Johannes-Trummer/Re-EMF-Projekt/Dokumentation/Bilder PCB-Design/bestuecktePlatine.jpg

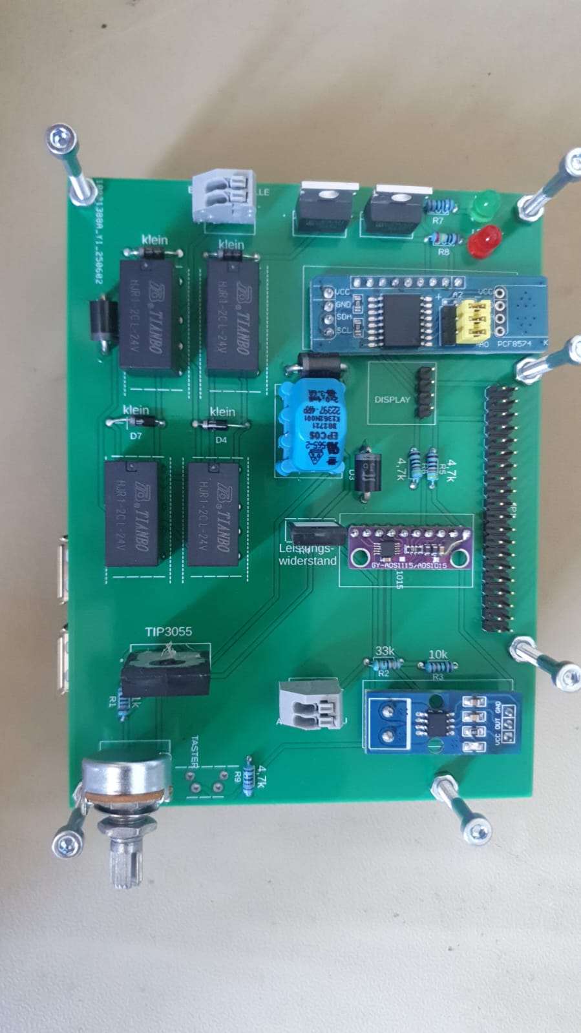
Dokumentation/Bilder PCB-Design/bestuecktePlatine.jpg
