Johannes-Trummer/Re-EMF-Projekt/Dokumentation/Dokumentation_EmbeddedSystems3.pdf

## Hochschule fur Technik, Wirtschaft und Kultur ¨

## Fakultät Ingenieurwissenschaften

# Projektarbeit

Embedded Systems 3

Thema: | Entwurf eines Re-EMF-Ladegerätes fur Bleiakkumulatoren ¨
Autor: | Leon Arnecke, Johannes Trummer MatNr. 79511, 87051
Version vom: | 29. September 2025
Prufer: ¨ | Prof. Dr.-Ing Andreas Pretschner

## Inhaltsverzeichnis

1 Einleitung | 3
2 Design des PCB | 4
2.3 Ubertragung des Schaltplans auf die Platine | ¨ | 5
2.5 Bestuckung der Platine | ¨ | 7
3 Entwurf Linux-System | 8
4 Entwurf des Programms | 12
4.1 Ziel und Modulubersicht | ¨ | 12
4.2 Einzeubersicht | ¨ | 12
5 Test und Inbetriebnahme | 15
6 Zusammenfassung und Ausblick | 19
Abbildungsverzeichnis | 20

2

## 1 Einleitung

Bleiakkumulatoren gehören trotz ihres Alters nach wie vor zu den am häufigsten eingesetzten Energiespeichern. Ihre einfache Bauweise, robuste Charakteristik und vergleichsweise niedrigen Kosten machen sie fur viele Einsatzzwecke attraktiv. Damit einher geht ¨ die Notwendigkeit einer zuverlässigen und effizienten Ladeelektronik, die sowohl die Lebensdauer der Akkumulatoren verlängert als auch eine sichere Regeneration tiefentladener Zellen ermöglicht.

Im Rahmen dieses Projekts wurde eine Re-EMF-Schaltung zur Ladung und Regeneration von Bleiakkumulatoren entwickelt. Ziel war es, den Ladevorgang durch Nutzung der Gegen-Elektromotorischen Kraft (Re-EMF) zu optimieren und ein schonendes, kontrolliertes Ladeverfahren zu realisieren. Die vollständige Schaltung wurde eigenständig entworfen und als Leiterplatte gefertigt.

Die Steuerung des Ladevorgangs ubernimmt ein STM32MP135 Mikroprozessorboard. ¨ Es läuft unter einem Linux-Betriebssystem, das mit Hilfe des Yocto-Projekts speziell
fur diesen Anwendungsfall erstellt wurde. Der zugeh ¨ | örige Ladealgorithmus wurde in der
Programmiersprache C implementiert und auf die zugrunde liegende Hardware abgestimmt.

Diese Arbeit dokumentiert die Entwicklung des Gesamtsystems – von der Konzeption der Ladeelektronik uber die Realisierung der Steuerung bis hin zur Softwareumsetzung. ¨ Dabei liegt der Fokus auf dem Zusammenspiel zwischen Hardwaredesign und softwarebasierter Steuerung zur sicheren und effektiven Ladung von Bleiakkumulatoren.

3

## 2 Design des PCB

### 2.1 Designprozess

Die vorliegende Leiterplatte wurde mit der Software Fusion 360 im integrierten Modul PCB Design entworfen. Fur die Umsetzung kam eine kostenlose Studentenlizenz zum ¨ Einsatz, die den vollen Funktionsumfang der Software fur nicht-kommerzielle Bildungs- ¨ zwecke bereitstellt. Die Nutzung dieser Lizenz ermöglichte eine professionelle Umsetzung des Designs unter Berucksichtigung aktueller Industriestandards. ¨

### 2.2 Entwurf des Schaltplans

Der Schaltplan wurde im Fusion 360 PCB Design-Modul erstellt und bildet die Grund-
lage fur das gesamte Platinenlayout. Da viele der ben ¨ | ötigten Bauteile nicht in den Stan-
dardbibliotheken enthalten waren, mussten sowohl die Schaltsymbole als auch die zugehörigen Footprints manuell erstellt werden. Die dafur erforderlichen Informationen ¨ wurden sorgfältig den jeweiligen Datenblättern der Hersteller entnommen. Diese Vorgehensweise stellte sicher, dass alle Bauteilabmessungen, Pinbelegungen und elektrischen Eigenschaften korrekt umgesetzt wurden. Trotz des erhöhten Aufwands bot Fusion 360
durch die enge Verknupfung von Schaltplan und Layout eine effiziente Umgebung f ¨ | ur ¨
die Entwicklung eines konsistenten und funktionsfähigen Designs.
In Abbildung 1 ist ein Ausschnitt des Schaltplans zu sehen, wie er in Fusion 360 PCB erstellt wurde. Die Symbole sind hauptsächlich eigens erstellt.

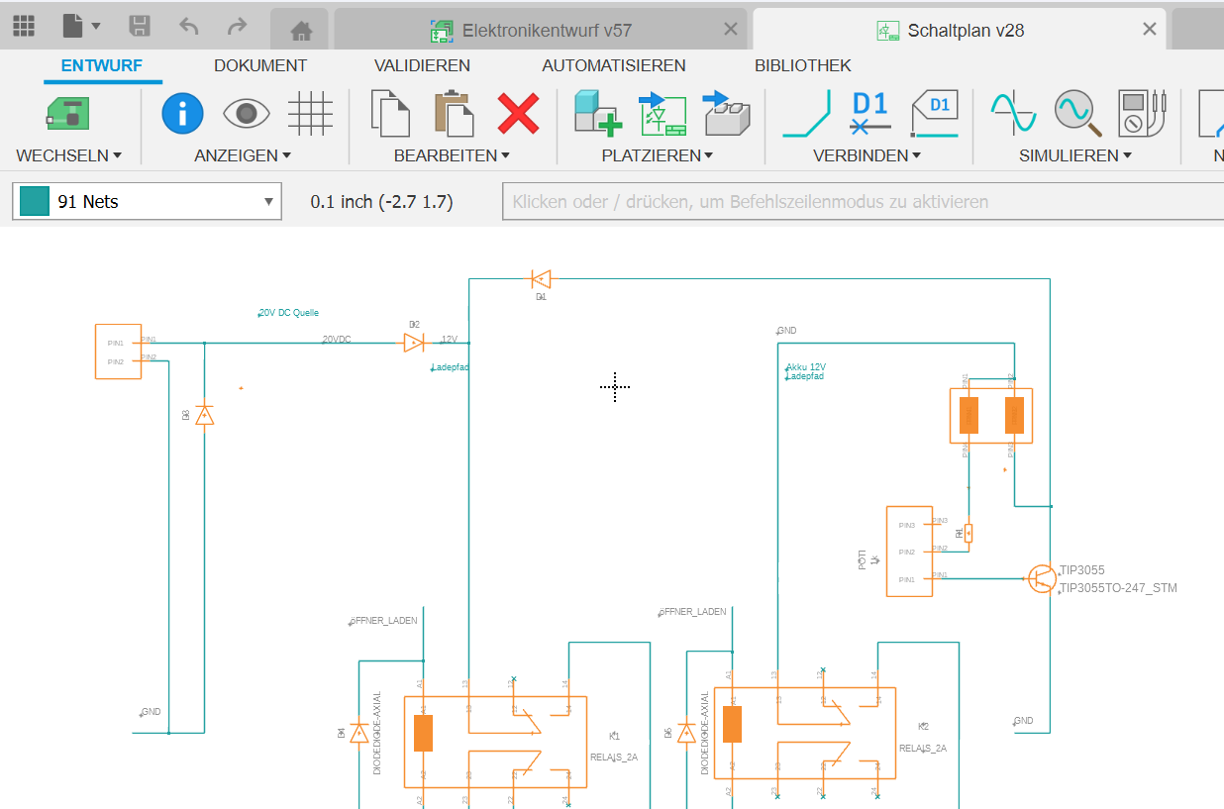
[picture p4: figure]

Abbildung 1: Ausschnitt des erstellten Schaltplans in Fusion 360 PCB Design

4

### 2.3 Ubertragung des Schaltplans auf die Platine ¨

Nach Fertigstellung des Schaltplans erfolgte die Ubertragung in das Leiterplatten-Layoutmodul ¨ von Fusion 360. Dabei wurde die im Schaltplan definierte Netzliste, die alle elektrischen Verbindungen zwischen den Bauteilen beschreibt, automatisch in das PCB-Design
ubernommen. Diese Netze dienten im Layoutprozess als Grundlage f ¨ | ur die sp ¨ | ätere Lei-
tungsfuhrung (Routing). ¨

Zunächst wurde die Grundfläche der Platine definiert, basierend auf den Platzanforderungen der Komponenten sowie den angestrebten mechanischen Abmessungen. Fur den ¨ Entwurf wurde von einer industriellen Fertigung ausgegangen, weshalb eine zweilagige Platine (2-Layer PCB) angenommen wurde – ein gängiger Standard fur viele elektroni- ¨ sche Anwendungen.

Die Platzierung der Komponenten auf der Platine erfolgte unter Berucksichtigung sinn- ¨
voller Signalflusse, minimaler Leitungsl ¨ | ängen sowie thermischer und mechanischer Aspek-
te. Dabei wurde insbesondere auf eine ubersichtliche und funktionsorientierte Anordnung ¨ geachtet, um spätere Tests, Fehlersuche und gegebenenfalls eine Bestuckung per Hand ¨ zu erleichtern.

Die zuvor im Schaltplan definierten Netzverbindungen wurden im Layout als Luftlinien dargestellt, die als visuelle Hilfe fur das Routing dienten. Diese Verbindungen ¨ wurden anschließend manuell auf den beiden verfugbaren Kupferlagen geroutet, wobei ¨ möglichst wenige Vias (Durchkontaktierungen) eingesetzt wurden, um Produktionskosten und mögliche Fehlerquellen zu minimieren.

Abbildung 2 zeigt die fertig erstellte Platine im PCB-Designer in Fusion 360 PCB. Die Löcher zum Befestigen am STM32MP135F-DK wurden aus den, von STM bereitgestellten, Unterlagen bezogen und auf der Platine platziert. Außerdem die Platine zum Schluss mit einem GND-Polygon versehen, um Störungen zu minimieren.

5

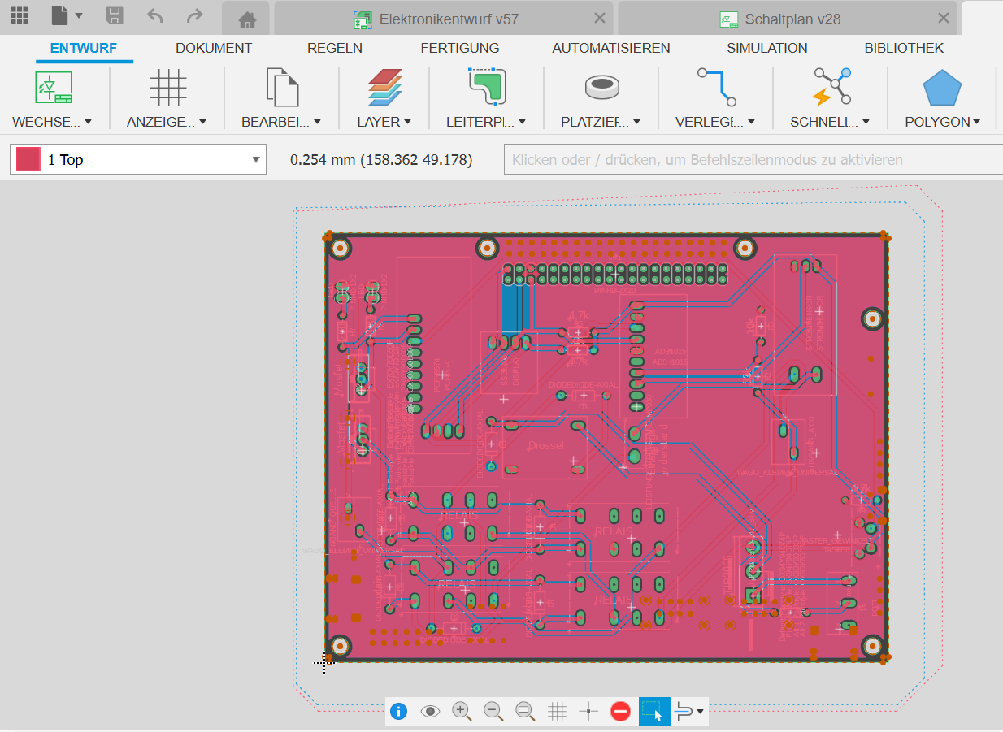
[picture p5: figure]

Abbildung 2: Fertig erstellte Platine mit Umrissen des Polygons

### 2.4 Bestellung der Platine und der Elektronikteile

Fur die Fertigung der entworfenen Leiterplatte wurde der chinesische Hersteller JLCP- ¨
CB gewählt. Dieser Anbieter bietet eine kostengunstige und zuverl ¨ | ässige Möglichkeit,
Prototypen sowie Kleinserien professionell herstellen zu lassen. Die Ubermittlung der ¨ Fertigungsdaten erfolgte in Form von standardisierten Gerber-Dateien, die direkt aus Fusion 360 exportiert wurden.
Die zur Bestuckung ben ¨ | ötigten elektronischen Bauteile wurden bei den bekannten Elek-
tronikhändlern Conrad Elektronik und Reichelt Elektronik bestellt. Diese Anbieter boten eine breite Auswahl und eine schnelle Lieferung der benötigten Komponenten, wodurch
eine zugige Inbetriebnahme der Platine erm ¨ | öglicht wurde.

6

### 2.5 Bestuckung der Platine ¨

Nach Lieferung der Leiterplatte und der elektronischen Bauteile erfolgte die manuelle
Bestuckung. Dabei wurden die zuvor bestellten Komponenten gem ¨ | äß dem Schaltplan
und dem Platinenlayout in die dafur vorgesehenen Positionen eingesetzt. Anschließend ¨ wurden alle Kontakte sorgfältig per Hand verlötet, um eine zuverlässige elektrische Verbindung herzustellen.

Die meisten Bauteile passten exakt in die vorgesehenen Bohrungen. Lediglich bei einigen wenigen Komponenten traten kleinere Probleme mit dem Lochdurchmesser auf – in diesen Fällen mussten die Anschlussdrähte leicht nachbearbeitet oder vorsichtig angepasst werden. Abgesehen davon verlief die Bestuckung weitgehend problemlos, und es konnte ¨ zugig mit der Inbetriebnahme der Schaltung fortgefahren werden. ¨

7

## 3 Entwurf Linux-System

Fur das STM32MP135F-DK wird ein Linux-Image mit Yocto gebaut, das eigene C- ¨ Programme bereits mitkompiliert im Root-Filesystem enthält. Die Builds laufen in einem Docker-Container unter Windows, um eine reproduzierbare und isolierte Umgebung zu erhalten.

### 3.1 Voraussetzungen

- Windows 10/11 mit Docker Desktop.
- Projektordner mit Dateien: Dockerfile, hello.c, aus.c, laden.c, entladen.c, analogwerte.c und zustandsautomat.c.
- Internetzugang (Yocto-Layer werden via repo synchronisiert).

### 3.2 Docker-Container bauen und starten

Bevor die eigentliche Konfiguration des Builds gestartet werden kann, muss die Buildumgebung aufgebaut und gestartet werden. Dafur wurden diese Befehle genutzt: ¨

# Windows P owe rS hell

cd C: \ U se r s \Leon\Documents\ Yo c to P roj e c t

docke r b uil d −t yocto−stm32mp1 −f D o c k e rf i l e .

docke r run −i t −−name yocto−dev −v
// c / U se r s /Leon/Documents/ Yo c to P roj e c t : / work yocto−stm32mp1

Im Container sind die Projektdateien unter /work sichtbar.

### 3.3 Yocto-Quellen und Pakete holen

# Con ta iner−S h e l l

mkdir −p ˜/stm32mp1−yoc to

cd ˜/stm32mp1−yoc to

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

repo sync −j ”$ ( nproc ) ”

8

Beim ersten envsetup.sh pruft ST Pflichtpakete. Fehlende werden nachinstalliert. ¨ sudo apt−g e t update

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

### 3.4 Build-Environment setzen

cd ˜/stm32mp1−yoc to

source l a y e r s /meta−s t / s c r i p t s / env se tup . sh

Damit wird der Build-Ordner /stm32mp1-yocto/build-openstlinuxweston-stm32mp13-disco angelegt.

### 3.5 Eigenen Layer und Sammel-Rezept erstellen

Wir bundeln alle C-Programme in einem Paket ¨ | battery-tools, das die sechs Binaries
nach /usr/bin installiert.

bi tba ke−l a y e r s c r ea t e −l a y e r . . / meta−myapp

bi tba ke−l a y e r s add−l a y e r . . / meta−myapp

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

9

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

Inhalt (Kurzfassung):

- LICENSE = MIT" mit aktuellem LIC FILES CHKSUM.
- SRC URI listet alle sechs .c-Dateien.
- do compile: sechs Binaries bauen.
- do install: nach ${bindir} installieren.

### 3.6 Paket ins Image ziehen und bauen

echo ’IMAGE INSTALL: append =
” ba t t e r y−t o o l s ” ’ >> co nf / l o c a l . co nf

echo ’ACCEPT EULA stm32mp13−di s c o = ”1” ’ >> co nf / l o c a l . co nf

bi t ba k e ba t t e r y−t o o l s

### 3.7 Image bauen (Weston-Variante)

bi t ba k e s t−image−weston

### 3.8 SD-Karten-Image erzeugen

Nach abgeschlossenem Build liegen die Artefakte in:
cd tmp−g l i b c / deploy / images /stm32mp13−di s c o

Das SD-Image wird mit dem ST-Skript aus einer TSV erstellt. Fehlende Tools wie sgdisk nachinstallieren:

10 sudo apt−g e t i n s t a l l −y g di s k

cd s c r i p t s

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

Ergebnis: FlashLayout sdcard stm32mp135f-dk-extensible.raw im Deploy-Ordner.

# P owe rS hell ( Host )

docke r cp yocto−dev : / home/ yoc to /
stm32mp1−yoc to / b uil d−o p e n s tli n u xw e s to n−stm32mp13−di s c o / tmp−g l i b c / deploy / images /stm32mp13−di s c o /
FlashLayou t sdca rd s tm32mp135f−dk−e x t e n s i b l e . raw
C: \ U se r s \Leon\Documents\ Yo c to P roj e c t \

Abschließend kann die Datei mit Hilfe von BalenaEtcher unter Windows oder mit geeigneten Werkzeugen (z. B. dd oder spezialisierte GUI-Programme) unter Linux auf eine SD-Karte geschrieben werden.

11

## 4 Entwurf des Programms

### 4.1 Ziel und Modulubersicht ¨

Das System umfasst mehrere eigenständige Testprogramme sowie ein Hauptprogramm mit Zustandsautomat. Die Module sind:

- hello – Konsolentest ("Hallo vom STM32MP13!").
- aus, laden, entladen – Einzeltests fur den I/O-Expander PCF8574. Sie initiali- ¨ sieren den Expander, setzen gezielt Pins und lesen einen Eingang.
- analogwerte – Einzeltest fur den ADC ADS1015: liest AIN0 und AIN1 zyklisch ¨ und rechnet auf Volt bzw. mA um.
- zustandsautomat – Hauptprogramm: steuert Laden/Entladen uber den PCF8574, ¨ misst Spannung/Strom via ADS1015, akkumuliert eine Ladungsgröße und verwaltet den Ablauf uber eine explizite Zustandsmaschine. ¨

### 4.2 Einzeubersicht ¨

hello. Minimaler Konsolotest zum Funktionscheck der Toolchain/RootFS.

aus / laden / entladen. Diese drei Programme initialisieren den PCF8574, konfigu-
rieren gewunschte Pins als Output oder Input und lesen zus ¨ | ätzlich Pin 2 als Eingang
(Taster). Beispielhafter Ablauf:

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

Die konkrete Belegung: Pin 0 = Laden, Pin 1 = Entladen, Pin 2 = Starttaster.

analogwerte. analogwerte misst in einer Endlosschleife nacheinander Kanal 0 und
Kanal 1 und gibt die Werte aus. Die Skalierung fur AIN0 ist aktuell ¨ | U = 4,35 ·UADC, die
Stromberechnung basiert auf I [mA] = 1000 · (9,88 · UADC − 25,27). Die Skallierung des Spannungskanals ist nötig, da die zu messende Spannung uber einen Spannungsteiler am ¨ ADC hängt. Die Parameter der Stromkurve wurden aus zwei Messpunkten berechnet.

12

### 4.3 Hauptprogramm: Zustandsmaschine

Das Hauptprogramm zustandsautomat kapselt die Steuerlogik in klar benannten Zuständen:

Z START, Z SPANNUNG MESSEN 1, Z LADEN AN, Z LADEN AUS, Z ZAEHLER ERHOEHEN,
Z ENTLADEN AN, Z ENTLADEN AUS, Z SPANNUNG MESSEN 2, Z STROM MESSEN, Z AUFSUMMIEREN,
Z ENDE
Zustandslogik (verkurzt). ¨ | Die zyklische Hauptschleife ruft ausgangslogik(zustand)
und berechnet anschließend den Folgezustand mit zustandsuebergang(zustand):

do {
a u s g a n g sl o gi k ( zu s tand ) ;
zu s tand = zu s tand suebe rgang ( zu s tand ) ;
} w hil e ( ! f e r t i g ) ;

In ausgangslogik( ) werden je nach Zustand Ausgänge gesetzt und Messungen durchgefuhrt, z.B.: ¨

- Z START:bei aktivem Taster Wechsel nach Z SPANNUNG MESSEN 1.
- Z SPANNUNG MESSEN 1 / 2: Einzelmessung ADS1015, Messung und Anzeige der Zellspannung.
- Z LADEN AN: Schalten des Lade-Relais; danach sleep(60) (Ladezeit).
- Z ENTLADEN AN: Schalten des Entlade-Relais.
- Z STROM MESSEN: ADS1015 messen, Strom ausrechnen.
- Z AUFSUMMIEREN: Ladungsgröße fortschreiben, 1 s abwarten
- Z ZAEHLER ERHOEHEN: Wiederholungszähler erhöhen
- Z ENTLADEN AUS: Entladen abschalten, Zeit-/Akkumulatoren zurucksetzen und Zwi- ¨ schenergebnis ablegen.
- Z ENDE: Messwertspeicher ausgeben, Ende.

13

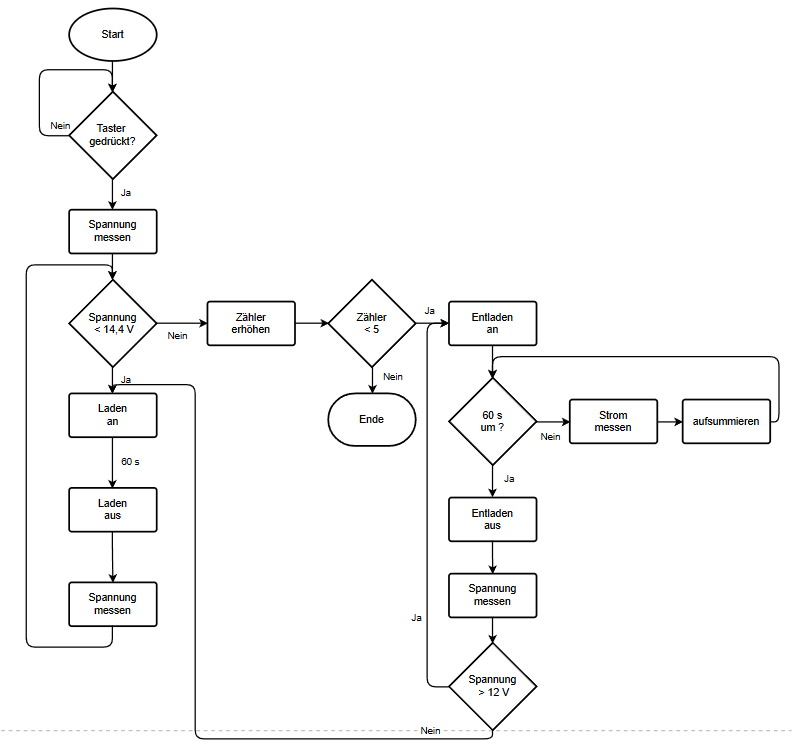
[picture p6: figure]

Abbildung 3: Ablaufdiagram

### 4.4 Zusammenfassung

Die Aufteilung in gezielte Einzeltests (PCF8574, ADS1115) erleichtert Verifikation und Fehlersuche; der Zustandsautomat orchestriert die Betriebsphasen (Laden/Entladen/-Messen) deterministisch. Das Open-Drain-Verhalten des PCF8574 (LOW = aktiv) ist da-
bei zentral fur die Relais-/Laststeuerung, w ¨ | ährend der ADS1115 im Single-Shot-Betrieb
reproduzierbare Messwerte liefert.

14

## 5 Test und Inbetriebnahme

### 5.1 Inbetriebnahme

Nachdem die Bestuckung der Platine abgeschlossen war, konnte diese f ¨ | ur die erste Inbe- ¨
triebnahme vorbereitet werden. Hierzu wurde die Baugruppe mittels eines 20×2-poligen Flachbandkabels mit dem STM32-Controller verbunden. Uber diese Verbindung werden ¨ sämtliche Steuersignale zwischen der Platine und dem Mikrocontroller ubertragen. ¨
Im Rahmen der initialen Inbetriebnahme liegt der Schwerpunkt zunächst darauf, die Baugruppe und den Controller ohne die Aktivierung spezifischer Funktionen in einen stabilen Betriebszustand zu versetzen. Auf diese Weise soll sichergestellt werden, dass die Schaltungsarchitektur sowie die Verdrahtung grundsätzlich fehlerfrei ausgefuhrt wur- ¨ den und keine unvorhergesehenen Betriebszustände auftreten.
Nachdem die Baugruppe uber einen Zeitraum von mehreren Minuten fehlerfrei betrieben ¨ wurde und weder Rauchentwicklung noch auffällige Geruchsbildung festgestellt werden konnten, kann im nächsten Schritt mit der schrittweisen Uberpr ¨ ufung der vorgesehenen ¨ Funktionen begonnen werden. Ziel ist es, die einzelnen Komponenten systematisch zu testen und die einwandfreie Funktionalität der gesamten Schaltung zu verifizieren.

15

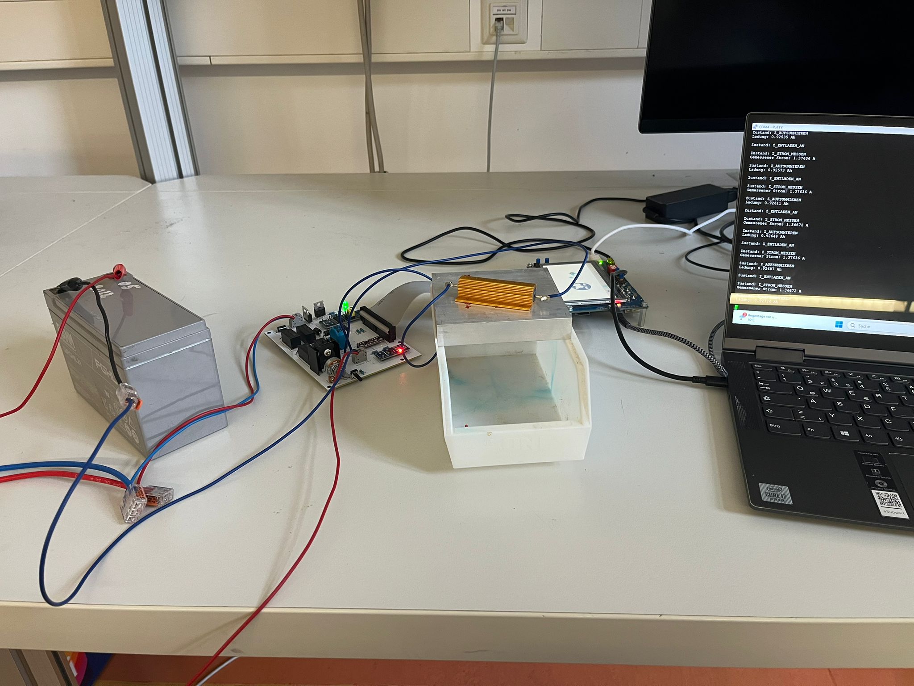
[picture p7: figure]

Abbildung 4: Platine und STM32-Controller während des ersten Akku-Zyklus

### 5.2 Test der Funktionen

Um eine ordnungsgemäße Funktion der Applikation sicherzustellen, mussen s ¨ ämtliche Funktionen systematisch und präzise getestet werden. Dabei ist es erforderlich, sowohl die zentralen Hauptfunktionen – wie den Lade- und Entladevorgang sowie den automatischen Betriebsablauf – zu uberpr ¨ ufen, als auch kleinere, jedoch nicht weniger wichtige ¨ Teilfunktionen zu validieren. Hierzu zählen beispielsweise die Kapazitätsmessung sowie die korrekte Ansteuerung der Status-LEDs.

Ein weiterer wesentlicher Aspekt betrifft die Ausgangsspannung der Schaltung. Da der primäre Zweck dieser Schaltung in der Regeneration von Bleigel-Akkus mittels gepulster Spannung liegt, ist es notwendig, die erzeugte Ausgangsspannung mithilfe eines Oszilloskops zu uberwachen und aufzuzeichnen. Auf diese Weise kann sichergestellt werden, ¨ dass die Pulsparameter den spezifizierten Anforderungen entsprechen und die Schaltung den Akku schonend und effektiv regeneriert.

### Laden

Um die Funktion des Ladens zu uberpr ¨ ufen, wird ein 12V-Blei-Gel-Akku an die Schal- ¨ tung angeschlossen. Dazu wird ein Oszilloskop parallel zum Akku angeschlossen, um

16 die Ausgangsspannung der Ladeschaltung aufzuzeichnen. Gleichzeitig muss der Ablauf des Steuerungsprogramms den richtigen Ausgang setzen, sodass der Ladepfad geschaltet wird.

### Entladen

Um den Akku zu entladen, muss der Programmablauf ebenfalls wieder den richtigen Pfad schalten, sodass der Strom aus dem Akku herausfließen und sich dieser damit entladen kann. Nun fließt der Strom aus dem Akku uber den Entladewiderstand und ¨ die Strommessung. Die Steuerung sollte nun zyklisch einen Strom messen und diesen so aufsummieren, dass die Kapazität des Akkus berechnet werden kann.

### Ausgangsspannung aufzeichnen

Die Ausgangsspannung der Ladeschaltung ist ein wichtiger Aspekt. Durch die gepulste Spannung soll im Bleiakku die Sulfatschicht um die Elektroden abgebaut werden, wodurch sich die Kapazität des Akkus in der Theorie wiederherstellen lässt. Somit ist das Pulsen der Spannung äußerst wichtig und muss mit Hilfe eines Oszilloskops aufgenommen werden, um die korrekte Funktion sicherzustellen.

### Ladungsmessung prufen ¨

Die Kapazitätsmessung an sich kann schwierig gepruft werden, da man daf ¨ | ur ein Mess- ¨
gerät bräuchte, welches die Kapazität eines Akkus misst. Die beiden Werte mussten ¨ dann verglichen werden. Da ein solches Messgerät nicht vorhanden ist, wurde die Kapa-
zitätsmessung in zwei Teilschritten uberpr ¨ | uft: erst die ¨ | Uberpr ¨ | ufung der Strommessung, ¨
dann die des zeitlichen Intervalls der Abtastung.
Die Strommessung konnte relativ einfach uberpr ¨ uft werden, indem das Entladen durch ¨ eine Spannungsquelle als Akku simuliert wurde und ein geeichtes Multimeter zur Strommessung in Reihe geschalten wurde. Uber den Entladewiderstand auf der Platine wurde ¨ dann ëntladen”. Der gemesssene Strom wurde nun an zwei Punkten mit dem gemessenen Strom des Multimeters verglichen, sodass die Kennlinie uberpr ¨ uft werden konnte. ¨
Das Testen des zeitlichen Intervalls stellte sich anfangs als nicht so einfach dar. Eine gute Möglichkeit wurde allerdings gefunden, indem die Anzahl der Abtastungen uber ¨ einen großen Zeitraum gezählt wurde. So sollte die Anzahl der Abtastungen bei einer Stunde Laufzeit beispielsweise 3600 betragen, da 3600 Sekunden. Dies war eine gute Möglichkeit, das zeitliche Intervall sehr genau einzustellen.

### Simulation des gesamten Ablaufs

Um den gesamten Programmablauf zu testen, muss sich die Spannung des Akkus entsprechend dem Lade- und Entladevorgang verändern. Da das Laden und Entladen eines

17

Akkus einige Zeit in Anspruch nimmt, wurde an dieser Stelle wieder eine Spannungsquelle als Simulation des Akkus eingesetzt. Die Startspannung liegt bei 12,5V.
Der Ladevorgang wurde nun gestartet. Die Lade-Eingangsspannung wurde nicht angelegt, da die erwähnte Spannungsquelle sonst die Ladespannung abbekommen wurde. ¨ Dadurch werden im trockenen Zustand einfach die Relais geschaltet und der Programmablauf kann getestet werden.
Die Spannung der Spannungsquelle wird nun auf 14,5V erhöht, wodurch die Steuerung im nächsten Messschritt (alle 60 Sekunden) einen fertig geladenen Akku feststellt, das Laden beendet und das Entladen startet. Auch im Zustand des Entladen wird die Spannung des Akkus alle 60 Sekunden gemessen. Dazwischen wird der Strom jede Sekunde gemessen.
Die Spannungsquelle wurde nun auf 11,8V gestellt. Jetzt wurde im nächsten Messschritt der entladene Akku festgestellt und wieder das Laden gestartet. Aktuell sind im Pro-
gramm funf Zyklen eingestellt. Der beschriebene Ablauf wurde also insgesamt f ¨ | unfmal ¨
durchlaufen, bevor das Programm sich selbst beendet. Der Programmablauf wurde damit korrekt getestet.

### Test des Zyklus mit Akku

Zu guter Letzt werden die Schaltung und der Ablauf mit einem 12V Bleiakku betrieben.
Die Voraussetzung dafur war, dass alle vorherigen Tests erfolgreich durchgef ¨ | uhrt werden ¨
konnten, was der Fall war. Nun wurde also am Akku-Port der 12V Akku angeschlossen und eine 20V DC-Quelle am Port fur die Eingangsspannung. ¨
Nach dem Start des Zyklus wird als Erstes entladen. Dabei wird auf dem Serial Output bei jeder Messung der Strom sowie die kumulierte Ladung angezeigt. Erreicht der Akku im Leerlauf eine Spannung von unter 12V, so schaltet die Steuerung nun in den Modus laden um. Nun wird der Akku geladen, bis er im Leerlauf eine Spannung von uber 14,4V ¨ erreicht.
Abschließend konnte durch diesen Test die Funktion sowohl der Schaltung als auch der Steuerung validiert werden. Es war in beiden Modi Laden und Entladen ersichtlich, dass die erwarteten Ergebnisse eingetreten sind und der Akku sich jeweils wie erwartet verhielt.

18

## 6 Zusammenfassung und Ausblick

Zusammenfassend wurde während des Projekts eine Applikation entwickelt, mit der ein 12V Akkumulator in einem vollautomatischen Zyklus geladen und anschließend wieder entladen werden kann. Dabei wird die Leerlaufspannung des Akkus konstant uberwacht ¨ und mittels Strommessung die Kapazität/ Elektrische Ladung des Akkus gemessen. Anhand der Messung und der zyklischen Wiederholung kann am Ende mehrerer Zyklen verglichen werden, wie sich die elektrische Ladung nach dem Laden des Akkus mit der Regenerationsschaltung entwickelt hat.
Die gepulste Spannung, die fur die Desulfatierung der Elektroden dienen sollte, konnte ¨ während der Messungen nicht aufgezeichnet werden. Allerdings könnte dies daran liegen, dass der Widerstand des Akkus so gering ist, dass der Akku die Spannungsspitzen sofort wegzieht und das Oszilloskop zu träge ist, um die Spitzen zu messen.
Auch ohne Pulse kann festgehalten werden, dass der Akku zuverlässig geladen werden konnte. Eine genaue Aussage, ob die Akkus regeneriert werden, ist zum aktuellen Zeitpunkt noch nicht möglich. Während des Projekts wurden Akkus mit ursprunglich 7,2 ¨ Ah verwendet. Bei realistisch noch möglichen 4-5 Ah und einem Entladestrom von 1,4 A dauert ein einziger Entladevorgang fast drei Stunden. Um eine ordentliche Aussage tref-
fen zu können, sollten mindestens funf Zyklen durchlaufen werden. Die n ¨ | ötige Zeit zum
funfmaligen Laden und Entladen konnte w ¨ | ährend des Projekts nicht zusammenhängend
aufgebracht werden.
Aus diesem Grund soll in Zukunft zunächst ein kleinerer Akku verwendet werden, da
die Zeiten dadurch deutlich verkurzt werden k ¨ | önnen. Dies gilt als wesentlicher Verbes-
serungsvorschlag.
Weitere Verbesserungsmöglichkeiten sind:
- genauere Strommessung - die Genauigkeit der Strommessung kann verbessert werden, da der aktuelle Messbereichsendwert 5 A beträgt
- graphische Darstellung des Verlaufs der elektrischen Ladung - eine graphische Darstellung der elektrischen Ladung wurde die Ergebnisse anschaulicher ¨ machen
- Usability - die Usability könnte beispielsweise durch Nutzung des Displays des STM-Controllers verbessert werden
- Verwendung anderer Drossel - durch die Verwendung einer anderen Drossel könnte das Pulsen der Spannung eventuell verstärkt werden, sodass es auf dem Oszilloskop sichtbar wird

Es wäre denkbar, diese Verbesserungen in Zukunft umzusetzen, um eine finale Aussage treffen zu können, ob die Re-EMF-Schaltung die elektrische Ladung von Bleiakkumulatoren effektiv regenerieren kann.

19

## Abbildungsverzeichnis

1 | Ausschnitt des erstellten Schaltplans in Fusion 360 PCB Design | | 4
2 | Fertig erstellte Platine mit Umrissen des Polygons | | 6
3 | Ablaufdiagram | | 14
4 | Platine und STM32-Controller während des ersten Akku-Zyklus | | 16

20
