Johannes-Trummer/Re-EMF-Projekt/SystemsEngBeleg/Dokumentation_Systemsengineering.pdf

## Hochschule fur Technik, Wirtschaft und Kultur ¨

## Fakultät Ingenieurwissenschaften

# Abschlussarbeit

Systemsengineering

Thema: | Entwurf eines Re-EMF-Ladegerätes fur Bleiakkumulatoren ¨
Autor: | Leon Arnecke, Johannes Trummer
| MatNr. 79511, 87051
E-Mail Leon: | leon.arnecke@stud.htwk-leipzig.de
E-Mail Johannes: | johannes.trummer@stud.htwk-leipzig.de
Version vom: | 5. Juni 2025
Prufer: ¨ | Prof. Dr.-Ing Thomas Neumuth

## Inhaltsverzeichnis

1 Einfuhrung ¨ | 3
1.2 Anwendungsubersicht und Nutzungskontext | ¨ | 3
1.4 Rahmenbedingungen fur die Systemauslegung | ¨ | 5
2 Systembeschreibung | 7
2.3 Technische und Physikalische Widerspruche | ¨ | 10
2.3.1 | Technische Widerspruche | ¨ | 10
2.3.2 | Physikalische Widerspruche | ¨ | 12
3 Systementwurf | 14
3.1 Auflösung der technischen Widerspruche | ¨ | 14
3.2 Auflösung der physikalischen Widerspruche | ¨ | 15
3.4 Uberblick Ladealgorithmus | ¨ | | 16
3.5.5 | Mechanik und Kuhlung | ¨ | 19
4 Zusammenfassung und Fazit | 21
5 Eidesstattliche Erklärung | 22
Abbildungsverzeichnis | 23
Literaturverzeichnis | 24

2

## 1 Einfuhrung ¨

### 1.1 Aufgabenstellung

Die Entwicklung effizienter Ladeverfahren fur Batterien und Akkumulatoren ist ein zen- ¨ trales Thema in der modernen Energietechnik.

In dieser Arbeit wird ein systematischer Zugang zur Thematik des Ladens von Energiespeichern verfolgt. Im ersten Schritt erfolgt eine umfassende Systemanalyse, mit der das technische und funktionale Umfeld eines Ladesystems beschrieben und eingegrenzt wird. Ziel ist es, die relevanten Komponenten, Wechselwirkungen und Rahmenbedingungen zu erfassen, die beim Laden von Akkumulatoren eine Rolle spielen.

Darauf aufbauend werden die Anforderungen an ein ideales Ladesystem formuliert. Im Abgleich mit bestehenden Systemen werden zentrale Widerspruche und techni- ¨ sche Zielkonflikte identifiziert. Diese dienen als Ausgangspunkt fur die Anwendung ¨ der TRIZ-Methode (Theorie des erfinderischen Problemlösens), mit der syste-
matisch Lösungsideen fur widerspr ¨ | uchliche Anforderungen entwickelt werden k ¨ | önnen.

Im weiteren Verlauf der Arbeit werden verschiedene technologische Konzepte zur Realisierung eines geeigneten Ladesystems gegenubergestellt und bewertet. Abschließend wird ¨ eine bevorzugte Lösungstechnologie ausgewählt und durch eine technische Implementierung detailliert beschrieben. Ziel dieser Arbeit ist es, ein strukturiertes Verständnis fur die Konstruktion innovativer Ladesysteme zu gewinnen und eine methodisch fun- ¨ dierte Lösung zu erarbeiten.

### 1.2 Anwendungsubersicht und Nutzungskontext ¨

Die folgende Abbildung veranschaulicht zentrale Nutzungsszenarien und Interaktionen verschiedener Akteure mit dem Ladesystem. Im Fokus stehen dabei der Endnutzer, das Entwicklerteam sowie ein ubergeordnetes System, das etwa in einer vernetzten Infra- ¨ struktur oder einem Energieverbund agiert.

Der Endnutzer initiiert den Prozess durch das Anschließen eines Akkus. Daraufhin kann wird ein Ladevorgang mit einer Regeneration eingeleitet. Im Anschluss steht der
geladene und regenerierte Akku wieder zur Verfugung. Zus ¨ | ätzlich werden akkuspezifi-
sche Informationen bereitgestellt.

Der Entwickler nutzt gesammelte Betriebsdaten zur gezielten Systemverbesserung. Die-
ser Ruckkopplungsprozess unterst ¨ | utzt die iterative Weiterentwicklung des Ladesystems ¨
auf Basis realer Einsatzbedingungen.

3

Das ubergeordnete System ¨ | greift sowohl auf Daten des Ladeprozesses als auch auf
Regenerationsfunktionen zu. Es kann diese Informationen fur ¨ ubergeordnete Aufgaben ¨ wie Energiemanagement oder das Recycling nicht mehr verwendbarer Akkus nutzen.

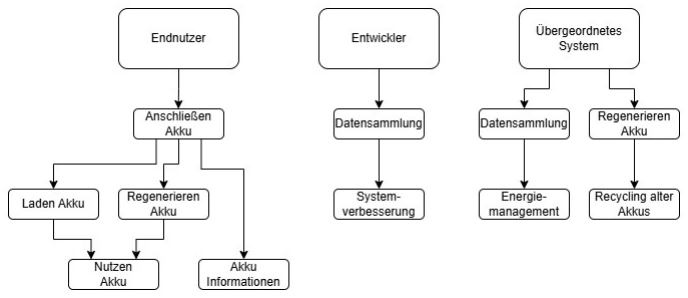
[picture p8: figure]

Abbildung 1: Use-Case-Diagramm

### 1.3 Systemumfeld

Das Systemumfeld eines Ladesystems fur Batterien und Akkumulatoren l ¨ | ässt sich in
drei wesentliche Einflussbereiche gliedern: Personengruppen, Umweltbedingungen und Fremdsysteme. Diese Kategorien stellen unterschiedliche Anforderungen an die Gestaltung, Sicherheit und Funktionsweise des Systems. Zu den mit dem System interagierenden Personengruppen zählen Endnutzerinnen und Endnutzer, Wartungspersonal, Entwicklungsund Fertigungspersonal. Das Ladesystem kann unterschiedlichen Umwelteinflussen aus- ¨ gesetzt sein, je nach Einsatzgebiet. Wesentliche Einflussfaktoren sind Temperatur, Feuchtigkeit und Staub, Mechanische Belastungen, Elektromagnetische Einflusse. Auch Fremd- ¨ systeme spielen hier eine Rolle, die Ladestation kann auf externe Energiesysteme oder Datenspeichersysteme angewiesen sein. Außerdem ist zur netzwerkbasierten Kommunikation ein entsprechendes System sinnvoll.

Die genannten Anforderungen aus dem Personen-, Umwelt- und Systemkontext bilden
die Grundlage fur die sp ¨ | ätere Systemauslegung und fließen direkt in die Bewertung
möglicher Lösungskonzepte ein.

4

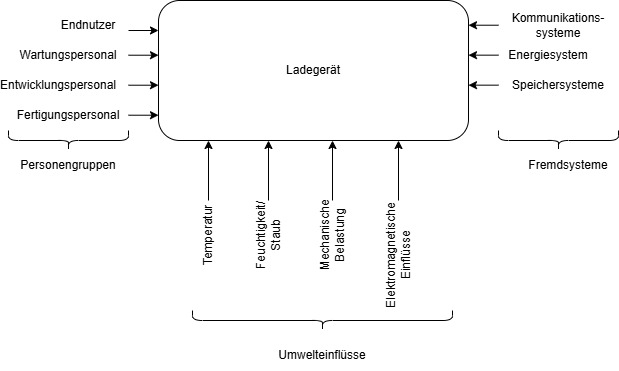
[picture p9: figure]

Abbildung 2: Systemumfeld des Ladesystems

### 1.4 Rahmenbedingungen fur die Systemauslegung ¨

Zur Festlegung der zu berucksichtigenden Rahmenbedingungen, werden oben genann- ¨
te Einflussgruppen auf deren Bedurfnisse und Anforderungen gepr ¨ | | uft. Dies dient der ¨
genaueren analyse der Systemeigenschaften.

### 1.4.1 Personen

- Endnutzerinnen und Endnutzer: Sie bedienen das Gerät im Alltag. Fur diese ¨ Zielgruppe sind insbesondere Aspekte wie einfache Handhabung, selbsterklärende
Benutzerfuhrung, visuelles Feedback ¨ | uber Ladezust ¨ | ände und ein sicherer Betrieb
von zentraler Bedeutung. Auch die potenzielle Fehlbedienung muss berucksichtigt ¨ werden.
- Wartungspersonal: Fur diese Gruppe ist ein einfacher Zugang zu technischen ¨ Komponenten essenziell, etwa zur Prufung, Kalibrierung oder zum Austausch de- ¨ fekter Bauteile. Das System sollte eine Diagnosemöglichkeit sowie dokumentierte Schnittstellen bieten.
- Entwicklungs- und Fertigungspersonal: Diese Gruppe benötigt ein modulares und nachvollziehbares Systemdesign, um Herstellung, Montage, Inbetriebnahme und Weiterentwicklung zu erleichtern.

5

### 1.4.2 Umwelt

- Temperatur: Schwankungen in der Umgebungstemperatur können sich auf die Ladeeffizienz und die Sicherheit des Systems auswirken. Es muss ein geeigneter Temperaturbereich spezifiziert und durch konstruktive Maßnahmen (z. B. Kuhlung, ¨ Schutzschaltungen) abgesichert werden.
- Feuchtigkeit und Staub: Bei Einsatz in Außenbereichen oder Werkstätten muss das Gerät gegen Feuchtigkeit und Staub geschutzt sein. Eine entsprechende IP- ¨ Schutzklasse (z. B. IP54 oder höher) ist anzustreben.
- Mechanische Belastungen: Vibrationen, Erschutterungen oder St ¨ | öße – insbe-
sondere bei mobilen oder industriellen Anwendungen – erfordern eine robuste Bauweise und die sichere Befestigung empfindlicher Komponenten.
- Elektromagnetische Einflusse: ¨ | Das Gerät muss sowohl störungsarm arbeiten
als auch unempfindlich gegenuber elektromagnetischen St ¨ | örungen sein. Entspre-
chende EMV-Richtlinien sind einzuhalten.

### 1.4.3 Fremdsysteme

- Kommunikationssysteme: Das Ladegerät muss nahtlos in bestehende Kommunikationsinfrastrukturen integriert werden können, um Statusinformationen, Diagnosedaten oder Steuerbefehle auszutauschen. Dabei sind standardisierte Schnittstellen (z. B. CAN, UART, Ethernet) und Protokolle essenziell. Kompatibilität, Datenintegrität und Echtzeitfähigkeit spielen eine zentrale Rolle.
- Energiesystem: Das Ladegerät ist Bestandteil eines ubergeordneten Energiesy- ¨ stems und muss daher mit unterschiedlichen Energiequellen (Netzspannung, Generatoren, Solaranlagen) kompatibel sein. Schutzmechanismen gegen Spannungs-
schwankungen, Ruckspeisung und Netzst ¨ | örungen sind erforderlich.
- Speichersysteme: Datenspeichersysteme ermöglichen die Erfassung, Ablage und Analyse von Betriebs- und Diagnosedaten des Ladegeräts. Eine zuverlässige Anbindung uber geeignete Schnittstellen sowie ein sicherer und strukturierter Datenzu- ¨ griff sind entscheidend. Datenschutz, Datensicherheit und langfristige Verfugbarkeit ¨
der gespeicherten Informationen mussen gew ¨ | ährleistet sein.

6

## 2 Systembeschreibung

Das Ladegerät besteht aus mehreren funktionalen Einheiten, die gemeinsam das Laden und Regenerieren von Batterien oder Akkumulatoren ermöglichen und dabei verschiedene Anforderungen erfullen. Die zentrale Komponente ist die Steuerungseinheit, welche ¨ den gesamten Ladevorgang uberwacht und regelt. Sie ist mit einem Energiemodul ver- ¨ bunden, das entweder aus einer netzgebundenen Stromversorgung oder einer autarken Quelle wie einem Solarpanel besteht.

Fur die ¨ | Uberwachung relevanter physikalischer Gr ¨ | ößen wie Strom, Spannung und Tem-
peratur ist ein Messsystem integriert. Es liefert kontinuierlich Daten an die Steuerung, um eine bedarfsgerechte Regelung des Ladeprozesses zu ermöglichen. Zusätzlich existiert eine Benutzerschnittstelle, uber die Statusinformationen abgerufen und Einstellungen ¨ vorgenommen werden können.

Ein weiteres Modul dient der externen Kommunikation, beispielsweise zur Datenubertragung ¨ an ein zentrales System oder zur Fernkonfiguration. Die einzelnen Systemteile sind so konzipiert, dass sie modular und austauschbar aufgebaut sind, was die Wartung und Weiterentwicklung erleichtert.

Die Auslegung erfolgt unter Berucksichtigung robuster Umweltbedingungen, einer ef- ¨ fizienten Energieausnutzung sowie einfacher Bedienbarkeit durch unterschiedliche Benutzergruppen.

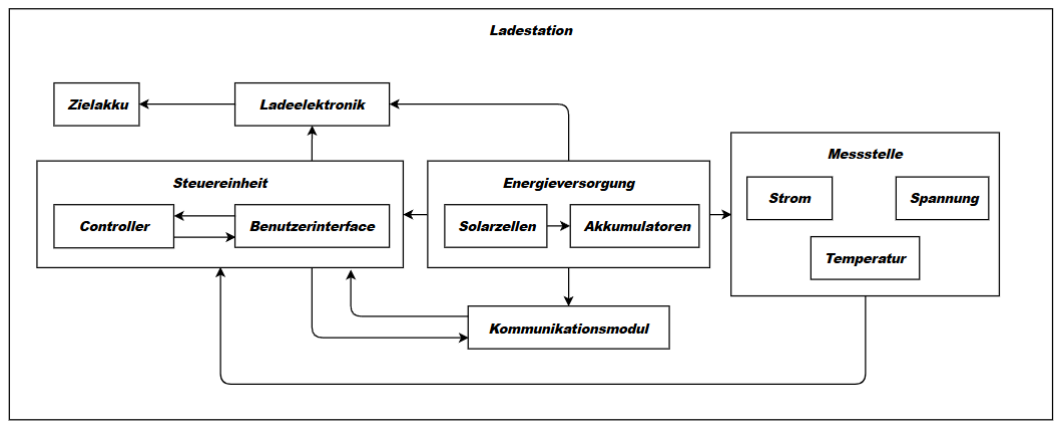
[picture p10: figure]

Abbildung 3: Block-Definition-Diagramm

7

### 2.1 Konzept des idealen Systems

Das Modell des idealen Systems beschreibt einen theoretisch optimalen Lade- und Re-
generationsprozess fur Akkumulatoren und Batterien, der sich vollst ¨ | ändig an den phy-
sikalischen, ökologischen und nutzerspezifischen Anforderungen orientiert – ohne dabei durch technische oder wirtschaftliche Einschränkungen begrenzt zu sein.

Ein ideales Ladesystem zeichnet sich durch folgende Merkmale aus:

- Automatische Anpassung: Das System erkennt automatisch den Typ, den Zustand und die Ladung der angeschlossenen Batterie und wählt den optimalen Ladealgorithmus entsprechend aus – unabhängig vom Hersteller oder der Technologie
(z. B. Li-Ion, NiMH, Blei).
- Effizienz: Der Ladevorgang erfolgt mit maximal möglichem Wirkungsgrad, d. h. es wird so wenig Energie wie möglich in Form von Wärme oder Verlustleistung verschwendet.
- Langlebigkeit: Das System verlängert durch eine schonende Ladekurve aktiv die Lebensdauer der Batterie. Uberladung, Tiefentladung oder Zellungleichgewichte ¨ werden zuverlässig vermieden.
- Regeneration: Das System ist in der Lage, bereits geschädigte oder gealterte Batterien zu analysieren und – sofern möglich – durch geeignete Ladeimpulse oder Regenerationszyklen wieder zu reaktivieren.
- Autarke Energieversorgung: Idealerweise benötigt das System keine externe Stromversorgung, sondern arbeitet vollständig energieautark (z. B. uber Solarener- ¨ gie), ohne Einbußen bei Ladeleistung oder -geschwindigkeit.
- Benutzerfreundlichkeit: Der Ladeprozess erfolgt fur die Nutzerin oder den Nut- ¨ zer vollständig automatisch. Eine Anzeige informiert uber den Ladefortschritt, oh- ¨ ne dass technisches Wissen notwendig ist.
- Nachhaltigkeit: Das System ist ressourcenschonend konstruiert, reparierbar und auf eine lange Lebensdauer ausgelegt. Es erfullt aktuelle Umweltstandards und ¨ kann sicher recycelt werden.

Dieses Idealmodell dient als Referenz zur späteren Bewertung realer Lösungsansätze. Abweichungen von diesem Modell deuten auf notwendige technische Kompromisse hin, deren Ursachen analysiert und deren Auswirkungen minimiert werden sollen.

8

### 2.2 Modellierung der Anforderungen

Das unten gezeigte Anforderungsdiagramm stellt die funktionalen und nicht-funktionalen Anforderungen an die Ladestation strukturiert dar. Die Anforderungen gliedern sich in mehrere Hauptkategorien:

- Energieversorgung: Die Ladestation soll eine autarke Energieversorgung ermöglichen, beispielsweise durch den Einsatz erneuerbarer Energien wie Photovoltaik. Zudem ist eine hohe Energieeffizienz gefordert, um den Energieverbrauch zu minimieren und einen nachhaltigen Betrieb sicherzustellen.
- Bedien- und Kommunikationsanforderungen: Diese Kategorie umfasst alle grundsätzlichen Interaktionseigenschaften der Ladestation. Dazu gehören z. B. die Fähigkeit zur Zustandsanzeige, um Nutzer uber den Ladefortschritt zu informieren, ¨ sowie die Kommunikationsfähigkeit mit externen Systemen. Zusätzlich wird gefordert, dass die Ladestation verschiedene Ladeprofile unterstutzt, um sich flexibel ¨ an unterschiedliche Anwendungsfälle und Bedienerwunsche anzupassen. ¨
- Sicherheits- und Diversitätsanforderungen: Diese Gruppe umfasst alle Anforderungen, die sich auf das sichere und anpassbare Laden unterschiedlicher Akkutypen beziehen. Die Ladestation muss verschiedene Akkutypen erkennen und
unterstutzen, indem sie Ladestr ¨ | öme und -spannungen entsprechend anpasst. Um
einen sicheren Betrieb zu gewährleisten, sind Schutzmechanismen wie Uberladeschutz ¨ und eine kontinuierliche Temperaturuberwachung zwingend erforderlich. ¨
- Betriebs- und Umgebungsanforderungen: Fur einen zuverl ¨ | ässigen und war-
tungsarmen Betrieb sind Anforderungen hinsichtlich einfacher Wartung und robuster Bauweise entscheidend. Die Ladestation muss unter verschiedenen Umwelt-
einflussen (z. B. Feuchtigkeit, Staub, Temperatur) zuverl ¨ | ässig funktionieren, was
durch eine entsprechend widerstandsfähige Konstruktion zu gewährleisten ist.

9

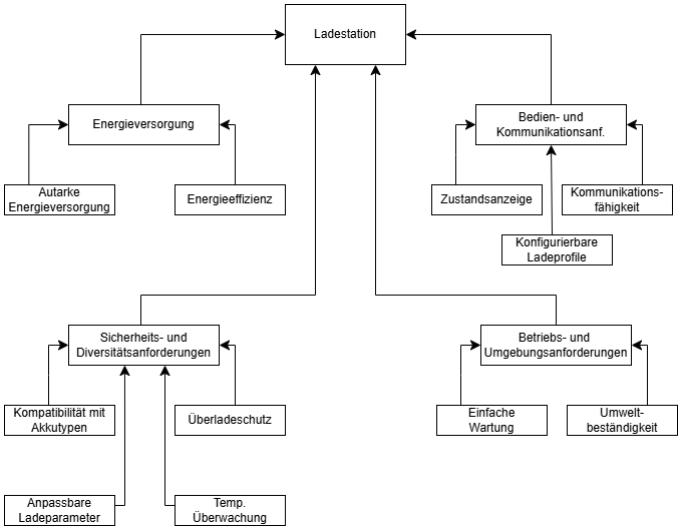
[picture p11: figure]

Abbildung 4: Requirements-Diagramm des Ladesystems

### 2.3 Technische und Physikalische Widerspruche ¨

### 2.3.1 Technische Widerspruche ¨

Technische Widerspruche treten auf, wenn durch die Verbesserung einer Eigenschaft des ¨ Systems eine andere Eigenschaft gleichzeitig verschlechtert wird.

Beispiele fur technische Widerspr ¨ | uche: ¨
- Schnellladung vs. Akkulebensdauer
Verbesserung: Die Ladezeit wird durch höheren Strom deutlich verkurzt. ¨ Verschlechterung: Die thermische und chemische Belastung verringert die Lebensdauer des Akkus.
- Hohe Effizienz vs. Baugröße der Schaltung
Verbesserung: Durch größere Kuhlk ¨ örper und leistungsfähige Bauteile wird der Wirkungsgrad verbessert.
Verschlechterung: Das System wird schwerer und weniger mobil.

10

- Energieeinsparung vs. Datenuberwachung ¨
Verbesserung: Durch Sleep-Modus wird der Stromverbrauch reduziert. Verschlechterung: Die zeitliche Auflösung der Messdaten sinkt, wichtige Informationen können verloren gehen.
- Hohe Kompatibilität vs. Komplexität der Steuerung
Verbesserung: Das Ladegerät kann verschiedene Akku-Typen verarbeiten. Verschlechterung: Die Software- und Hardwaresteuerung wird deutlich komplexer.

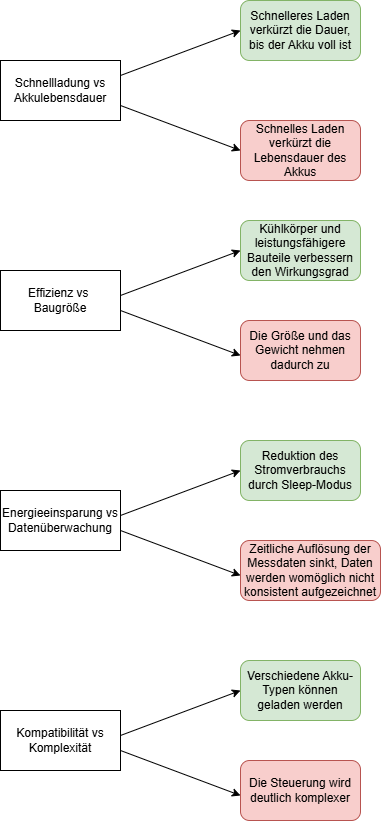
[picture p12: figure]

Abbildung 5: Technische Widerspruche ¨

11

### 2.3.2 Physikalische Widerspruche ¨

Physikalische Widerspruche liegen vor, wenn eine Eigenschaft eines Systems zwei entge- ¨ gengesetzte Anforderungen gleichzeitig erfullen soll. ¨

Beispiele fur physikalische Widerspr ¨ | uche: ¨ | [3]
- Die Temperatur der Schaltung soll niedrig und hoch sein
Begrundung: ¨ | Sie soll niedrig sein, um Bauteile zu schutzen, aber hoch genug, um ¨
die chemischen Prozesse beim Laden effizient zu gestalten.
- Die Bauform soll kompakt und gleichzeitig groß sein
Begrundung: ¨ | Kompakt fur Mobilit ¨ | ät, aber groß genug, um ausreichend Kuhlung ¨
und Bauraum fur leistungsf ¨ | ähige Komponenten zu bieten.
- Der Ladeprozess soll automatisiert und gleichzeitig individuell steuerbar sein
Begrundung: ¨ | Vollautomatisch fur einfachen Betrieb, aber auch flexibel f ¨ | ur unter- ¨
schiedliche Batterieparameter.
- Die Ladezeit soll kurz und lang sein
Begrundung: ¨ | Kurz, um Zeit zu sparen, aber lang, um den Akku besonders schonend
zu laden.

12

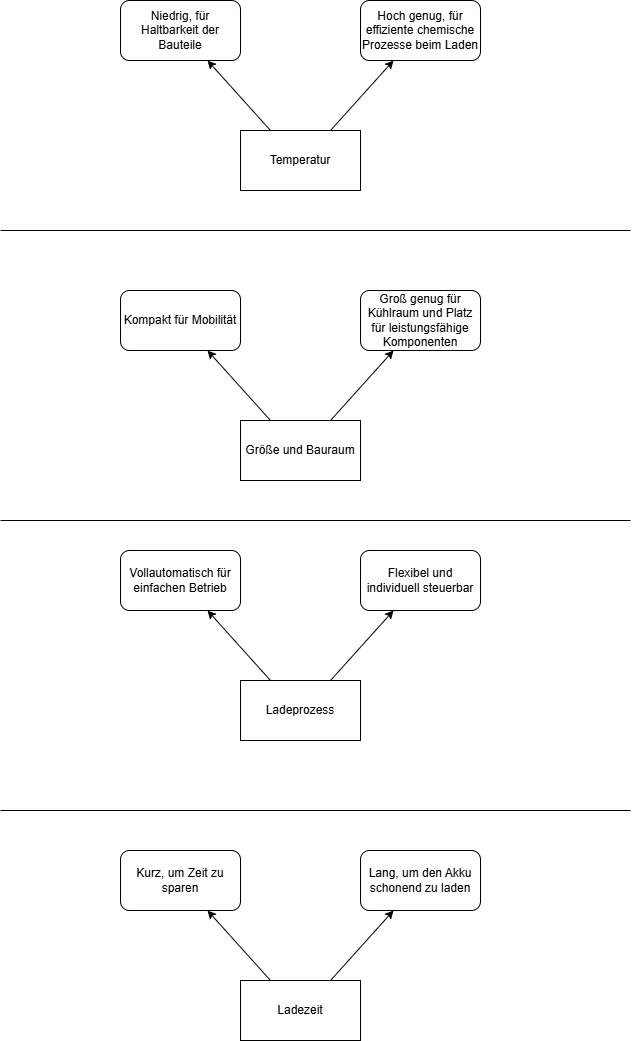
[picture p13: figure]

Abbildung 6: Physikalische Widerspruche ¨

13

## 3 Systementwurf

Im Rahmen dieser Arbeit wurden verschiedene technische und physikalische Wider-
spruche im Zusammenhang mit dem Aufbau eines Ladesystems f ¨ | ur Akkus und Bat- ¨
terien identifiziert. Zur strukturierten Lösung dieser Konflikte wird die TRIZ-Methode (Theorie des erfinderischen Problemlösens) herangezogen.

### 3.1 Auflösung der technischen Widerspruche ¨

Widerspruch 1: Eine hohe Ladespannung fuhrt zu schnellerem Laden, erh ¨ | öht aber
auch die Gefahr der Uberhitzung und Sch ¨ | ädigung der Batterie.
TRIZ-Lösung: Prinzip 19 – Periodische Wirkung: Statt konstanter hoher Spannung wird mit gepulster Spannung geladen, was die Batterie schont und gleichzeitig schnelles Laden erlaubt.[9]
Widerspruch 2: Mehr Kuhlung bedeutet besserer Wirkungsgrad, aber gr ¨ | ößere Bau-
form.
TRIZ-Lösung: Prinzip 6 – Universelle Nutzung: Das Gehäuse der Ladestation
ubernimmt zus ¨ | ätzlich die Funktion eines Kuhlk ¨ | örpers.[9]

Widerspruch 3: Ein Sleep-Modus reduziert den Energieverbrauch, verringert jedoch die zeitliche Auflösung der Datenuberwachung, wodurch wichtige Informationen verloren ¨ gehen können.
TRIZ-Lösung: Prinzip 23 – Ruckkopplung: ¨ | Das System verbleibt im Energiesparmo-
dus und wird nur bei relevanten Ereignissen durch Sensorsignale oder definierte Schwellenwerte aktiviert.[9]

Widerspruch 4: Ein Ladegerät, das viele Akku-Typen unterstutzt, bietet hohe Kom- ¨ patibilität, erfordert jedoch eine komplexe Steuerung, was Entwicklung und Wartung erschwert.
TRIZ-Lösung: Prinzip 25 – Selbstbedienung: Der angeschlossene Akku identifiziert
sich selbst uber eine digitale Schnittstelle (z. B. SMBus oder I2C) und ¨ | ubermittelt die ¨
notwendigen Ladeparameter direkt an das System.[9]

14

### 3.2 Auflösung der physikalischen Widerspruche ¨

Widerspruch 1: Die Temperatur des Akkus soll hoch sein, um chemische Prozesse zu
begunstigen, aber gleichzeitig niedrig, um Sch ¨ | | äden zu vermeiden.
TRIZ-Lösung: Trennung in der Zeit: Der Akku wird nur in kontrollierten Ladephasen leicht erwärmt, anschließend wieder gekuhlt. ¨

Widerspruch 2: Die Bauform soll gleichzeitig kompakt (platzsparend) und groß (fur ¨ Kuhlung und Bauraum) sein. ¨
TRIZ-Lösung: Trennung im Raum und Funktion: Kompakte, modulare Bauweise
mit ausgelagerten, belufteten Bereichen f ¨ | ur w ¨ | ärmeintensive Komponenten, sodass das
Hauptgerät mobil und platzsparend bleibt, während Kuhlung und Bauraum gew ¨ | ährleistet
sind.

Widerspruch 3: Der Ladeprozess soll automatisiert und gleichzeitig individuell steuerbar sein.
TRIZ-Lösung: Trennung der Bedingung: Automatischer Ladeprozess läuft unter Standardbedingungen, individuelle Steuerung wird nur bei speziellen Batterietypen oder Anforderungen aktiviert.

Widerspruch 4: Die Ladezeit soll kurz (schnellladen) und lang (vollgeladener und gut regenerierter Akku) sein.
TRIZ-Lösung: Trennung nach Zustand: Ladegeschwindigkeit wird abhängig vom Ladezustand des Akkus geregelt – zu Beginn schnell, bei hohem Ladezustand langsamer und schonender.

15

### 3.3 Interaktion zwischen Systemkomponenten

Das folgende Sequenzdiagramm stellt den allgemeinsten Ablauf eines Ladevorgangs aus Sicht der beteiligten Systemkomponenten dar. Die Interaktion beginnt mit dem Anschließen eines Akkus durch den Endnutzer. Uber das Benutzerinterface wird die Steuerungs- ¨ einheit aktiviert, welche die Sensorik abfragt und auf Basis der erhaltenen Messwerte den Ladevorgang initialisiert.

Während der Ladephase erfolgt die kontinuierliche Uberwachung durch die Sensorik. ¨ Nach erfolgreichem Abschluss gibt die Steuerung eine Fertigmeldung an das Interface weiter, woraufhin der Endnutzer den Akku wieder entfernen kann.

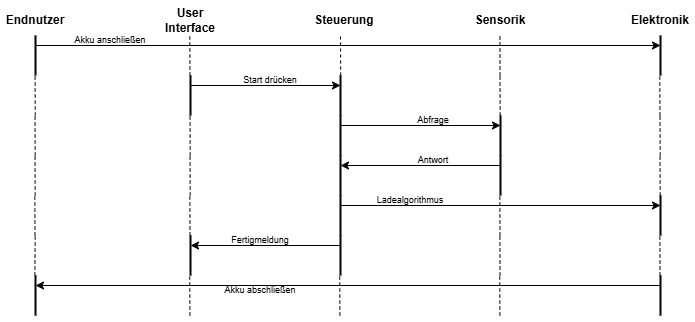
[picture p14: figure]

Abbildung 7: Sequenzdiagramm

### 3.4 Uberblick Ladealgorithmus ¨

Der Ladealgorithmus ist verantwortlich fur eine sichere, effiziente und akkuspezifische ¨
Durchfuhrung des Ladevorgangs. Nach der Initialisierung pr ¨ | uft die Steuerung kontinuier- ¨
lich die Systemwerte, um den Ladevorgang an den Zustand des Akkus anzupassen.[10] [2]

Der algorithmische Ablauf fur eine Re-EMF-Ladestation soll in folgendem Program- ¨ mablaufdiagramm veranschualicht werden:

16


Abbildung 8: Programmablaufdiagramm

### 3.5 Technologieauswahl

Zur Realisierung eines intelligenten und sicheren Ladesystems fur Akkus und Batterien ¨ ist es notwendig, eine geeignete Kombination aus Hard- und Softwaretechnologien zusammenzustellen. Die Auswahl der eingesetzten Komponenten und Verfahren orientiert sich an den zuvor identifizierten Anforderungen und Funktionen des Systems.

17

### 3.5.1 Zentrale Steuerungseinheit

Im Zentrum des Systems steht das STM32MP135-Board, das mit zwei Ethernet-Schnittstellen eine zuverlässige kabelgebundene Kommunikation ermöglicht. Es ubernimmt folgende ¨ Aufgaben:

- Steuerung des gesamten Ladeprozesses mittels Linux-basierter Softwarelogik,
- Verarbeitung sensorischer Eingaben in Echtzeit zur dynamischen Anpassung der Ladeparameter,
- Verwaltung von Kommunikationsprotokollen und Datenubertragung ¨ | uber Ether- ¨
net.

### 3.5.2 Ladeelektronik

Die Ladeeinheit wird so ausgelegt, dass sie den Anforderungen an gepulste Hochstromladung und Wärmevermeidung gerecht wird. Dabei werden folgende Prinzipien berucksichtigt: ¨

- Einsatz effizienter DC/DC-Wandler mit PWM-Steuerung,
- thermische Entkopplung der Leistungsmodule durch gezielte Anordnung (Prinzip: Trennung im Raum),
- Verwendung temperaturstabiler und modularer Leistungsbauteile.[5][7][1][8]

### 3.5.3 Sensorik

Zur Sicherstellung eines schonenden Ladeprozesses und zum fruhzeitigen Erkennen von ¨ Abweichungen werden verschiedene Sensoren integriert:

- Temperaturfuhler zur ¨ | Uberwachung des Batteriegeh ¨ | äuses und der Ladeelektronik,
- Spannungssensoren zur präzisen Ermittlung des Ladezustands,
- Stromsensoren zur Erfassung des Ladeflusses in Echtzeit.[4]

18

### 3.5.4 Kommunikation und Steuerlogik

Das STM32MP135 ermöglicht durch sein Linux-Betriebssystem den Einsatz flexibler Steueralgorithmen und Netzwerkprotokolle:[6]

- Kommunikation mit einem zentralen Server uber Ethernet f ¨ | ur ¨ Uberwachung und ¨
Logging,
- Echtzeitsteuerung durch Multi-Threading und deterministische Prozessfuhrung, ¨
- adaptive Regelstrategien zur Verlängerung der Batterielebensdauer.

### 3.5.5 Mechanik und Kuhlung ¨

Das Gehäusekonzept unterstutzt die Langlebigkeit und Funktionssicherheit der elektro- ¨ nischen Komponenten:

- gerichteter Luftstrom durch aktive Lufter oder passive Aluminiumk ¨ | uhlk ¨ | örper,
- robuste Bauweise zur Umgebungstauglichkeit im Außeneinsatz,
- mechanisch entkoppelte Halterung sensibler Messsysteme.

### 3.5.6 Energieversorgung

Fur station ¨ | äre oder autarke Anwendungen ist die Energieversorgung des Systems flexibel
gestaltbar:
- Einspeisung uber Netzteil oder Solarmodul mit Laderegler, ¨
- Pufferung durch eigene Akkuzelle zur Uberbr ¨ uckung instabiler Spannungsquellen, ¨
- hocheffiziente Stromversorgungsmodule mit Energiesparfunktionen.

### 3.6 Ausgeschlossene Technologien

Im Verlauf der Systemanalyse und Widerspruchsauflösung wurden verschiedene Technologien bewusst ausgeschlossen, da sie entweder bestehende Widerspruche nicht hinrei- ¨ chend auflösen konnten oder neue Nachteile mit sich gebracht hätten.

So wurde auf den Einsatz eines Mikrocontrollers mit integrierter WLAN-Schnittstelle (wie z. B. ESP32) verzichtet, da dieser zwar eine einfache drahtlose Kommunikation ermöglicht, diese jedoch bei gleichzeitiger Hochstromanwendungen häufig Instabilitäten zeigt. Dies steht im Widerspruch zur Anforderung einer stabilen und gekapselten Ladetechnologie.

19

Ebenso wurde die Nutzung rein analoger Ladeschaltungen verworfen. Zwar bieten sie in einfachen Anwendungen hohe Robustheit, lassen sich jedoch kaum dynamisch regeln oder mit intelligenten Steuermechanismen kombinieren – ein klarer Nachteil im Hinblick auf die notwendige Flexibilität zur regenerativen Akkupflege (aufgelöster technischer Widerspruch: hohe Ladegeschwindigkeit vs. Akkuschonung).

Ursprunglich war außerdem im Entwurfsprozess vorgesehen, Optokoppler zur galvani- ¨ schen Trennung und Signalubertragung einzusetzen. Sie bieten neben einem geringen ¨ Platzbedarf auch Vorteile hinsichtlich der Störfestigkeit und Sicherheit. Allerdings stellte
sich heraus, dass die verfugbaren Optokoppler in der geplanten Schaltung den ben ¨ | ötigten
Strom nicht effizient bzw. kostengunstig schalten konnten. Aufgrund der damit verbun- ¨ denen hohen Kosten wurde letztlich entschieden, auf den Einsatz von Optokopplern zu verzichten und alternative Schaltungskonzepte zu verfolgen.

20

## 4 Zusammenfassung und Fazit

Im Rahmen dieser Arbeit wurde ein innovatives Ladesystem zur energieeffizienten und akkuschonenden Aufladung von Batterien und Akkumulatoren konzipiert. Ziel war es, eine Lösung zu entwickeln, die sowohl leistungsfähig als auch nachhaltig und sicher ist. Dabei wurde ein systematischer Entwicklungsansatz verfolgt, der sich auf die strukturierte Analyse der Anforderungen, des Systemumfelds sowie auf die Auflösung technischer
und physikalischer Widerspruche mittels der TRIZ-Methode st ¨ | utzte. ¨

Auf Grundlage dieser Analyse wurde ein technologisches Gesamtkonzept erarbeitet, das auf dem STM32MP135 Mikrocontroller mit dualer Ethernet-Kommunikation basiert. Dieses System erlaubt die präzise Steuerung des Ladevorgangs, eine flexible Erweiterung durch Sensorik sowie die Integration moderner Regelalgorithmen zur Akkupflege. Weiterhin wurde eine geeignete Ladeelektronik entworfen, die sowohl hohe Ströme verarbeiten kann als auch eine thermisch entkoppelte Bauweise aufweist.

Besondere Aufmerksamkeit galt der Auswahl geeigneter Technologien: Während leistungsfähige Mikrocontroller und modulare Elektronik zum Einsatz kamen, wurden andere Technologien wie WLAN-basierte Systeme, rein analoge Laderegler oder drahtlose Energieubertragung aufgrund identifizierter Nachteile bewusst ausgeschlossen. ¨

Die Anwendung der TRIZ-Methode erwies sich dabei als wertvolles Werkzeug zur strukturierten Lösung komplexer Entwicklungsprobleme. Sie ermöglichte es, scheinbare Zielkonflikte – etwa zwischen hoher Ladeleistung und thermischer Stabilität – zu uberwinden ¨ und so ein ausgereiftes Systemdesign zu formulieren.

Abschließend lässt sich festhalten, dass das entwickelte Ladesystem nicht nur die funk-
tionalen Anforderungen erfullt, sondern auch zukunftsf ¨ | ähig und anpassbar gestaltet ist.
Es bietet die Grundlage fur eine breite Palette an Anwendungen, insbesondere in ener- ¨
gieautarken Umgebungen oder fur die Revitalisierung gebrauchter Akkus. Zuk ¨ | unftige ¨
Weiterentwicklungen könnten die Einbindung intelligenter Analysefunktionen oder die Optimierung der Energieversorgung weiter vorantreiben.

21

## 5 Eidesstattliche Erklärung

Hiermit erklären wir, dass wir die vorliegende Arbeit selbstständig verfasst haben, dass wir sie zuvor an keiner anderen Hochschule und in keinem anderen Studiengang als Prufungsleistung eingereicht haben und dass wir keine anderen als die angegebenen ¨ Quellen und Hilfsmittel benutzt haben. Alle Stellen der Arbeit, die wörtlich oder sinngemäß aus Veröffentlichungen oder aus anderweitigen fremden Außerungen entnommen ¨ wurden, sind als solche kenntlich gemacht.

Ort, Datum | Unterschrift

Unterschrift

22

## Abbildungsverzeichnis

1 | Use-Case-Diagramm | | 4
2 | Systemumfeld des Ladesystems | | 5
3 | Block-Definition-Diagramm | | 7
4 | Requirements-Diagramm des Ladesystems | | 10
5 | Technische Widerspruche | ¨ | 11
6 | Physikalische Widerspruche | ¨ | 13
7 | Sequenzdiagramm | | 16
8 | Programmablaufdiagramm | | 17

23

## Literatur

[1] Caddock Electronics. MP900 and MP9000 Series Kool-Pak® Power Film Resistors. Accessed on 2025-06-04. 2015. url: https://cdn-reichelt.de/documents/datenblatt/B300/MP900-SERIES_ENG_TDS.pdf. (https://cdn-reichelt.de/documents/datenblatt/B300/MP900-SERIES_ENG_TDS.pdf)
[2] Die echte Wiki. RE-EMF-Lader. Zugegriffen am: 3. Juni 2025. n.d. url: https: //dieechtewiki.de/index.php/RE-EMF-Lader.
[3] Sven Häwel. Akkus richtig laden – Langlebigkeit. Zugegriffen am: 3. Juni 2025. März 2025. url: https : / / www . homeandsmart . de / akkus - richtig - laden -langlebigkeit. (https://www.homeandsmart.de/akkus-richtig-laden-langlebigkeit)
[4] iDuino. ME066 Stromsensor – Bedienungs- und Sicherheitshinweise. Accessed on 2025-06-04. 2020. url: https : / / asset . conrad . com / media10 / add / 160267 / c1/- /en/001616235ML01/bedienungs- und- sicherheitshinweise- 1616235-iduino-me066-stromsensor-1-st.pdf. (https://asset.conrad.com/media10/add/160267/c1/-/en/001616235ML01/bedienungs-und-sicherheitshinweise-1616235-iduino-me066-stromsensor-1-st.pdf)
[5] Infineon Technologies. IRLZ44NPbF – HEXFET Power MOSFET. Datasheet accessed on 2025-06-04. 2020. url: https://asset.conrad.com/media10/add/160267/c1/-/en/000162877DS01/datenblatt-162877-infineon-technologiesirlz44npbf-mosfet-1-hexfet-110-w-to-220.pdf. (https://asset.conrad.com/media10/add/160267/c1/-/en/000162877DS01/datenblatt-162877-infineon-technologies-irlz44npbf-mosfet-1-hexfet-110-w-to-220.pdf)
[6] STMicroelectronics. STM32MP135F-DK Discovery Kit for STM32MP135 Line. Accessed on 2025-06-04. 2024. url: https : / / www . st . com / en / evaluation -tools/stm32mp135f-dk.html. (https://www.st.com/en/evaluation-tools/stm32mp135f-dk.html)
[7] TDK Electronics. B82721K2202N001 – SMD Ring Core Choke. Datasheet accessed on 2025-06-04. 2020. url: https://asset.conrad.com/media10/add/160267/c1/-/en/001719073DS01/datenblatt-1719073-tdk-b82721k2202n001-b82721k2202n001-drossel-ringkern-smd-b82721-1-mh-80-m-2-a-1-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. (https://asset.conrad.com/media10/add/160267/c1/-/en/001719073DS01/datenblatt-1719073-tdk-b82721k2202n001-b82721k2202n001-drossel-ringkern-smd-b82721-1-mh-80-m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)
[8] Tianbo Electronics. HJR1-2C-L-24VDC Printrelais – Technisches Datenblatt. Zugriff am 2025-06-04. 2020. url: https : / / asset . conrad . com / media10 / add / 160267/c1/-/de/000629501DS01/datenblatt-629501-tianbo-electronicshjr1-2c-l-24vdc-printrelais-24-vdc-2-a-2-wechsler-1-st.pdf. (https://asset.conrad.com/media10/add/160267/c1/-/de/000629501DS01/datenblatt-629501-tianbo-electronics-hjr1-2c-l-24vdc-printrelais-24-vdc-2-a-2-wechsler-1-st.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)
[9] TRIZ40.com. Die 40 Innovationsprinzipien der TRIZ-Methode. Zugriff am 2025-06-04. 2025. url: https://www.triz40.com/aff_Prinzipien_TRIZ.php.
[10] Wohnen und Heimwerken. Re-EMF Charger Ladegerät selber bauen – Akkus laden und regenerieren. Zugegriffen am: 3. Juni 2025. n.d. url: https : / / wohnen -heimwerken.de/re-emf-charger-ladegeraet-selber-bauen-akkus-ladenund-regenerieren.html. (https://wohnen-heimwerken.de/re-emf-charger-ladegeraet-selber-bauen-akkus-laden-und-regenerieren.html)

24
