Johannes-Trummer/Re-EMF-Projekt/Platine/Bauteile/Leistungswiderstand.png

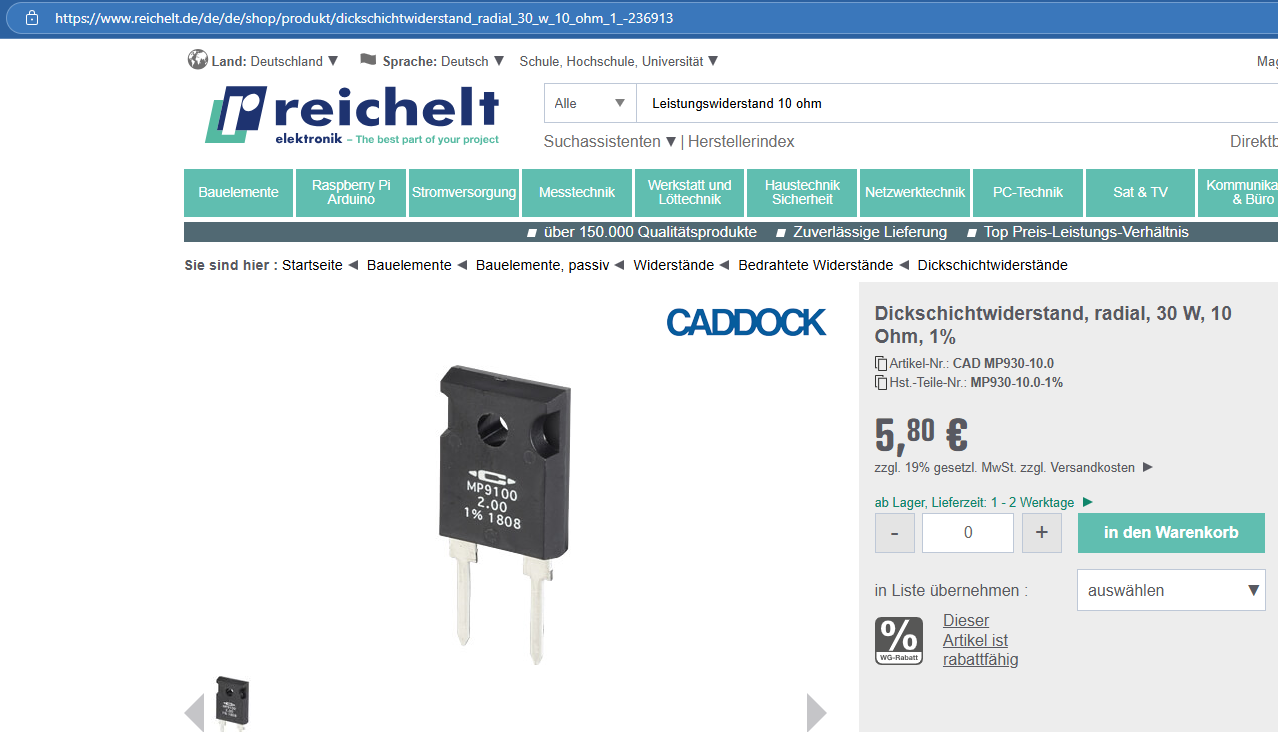
Platine/Bauteile/Leistungswiderstand.png
