Johannes-Trummer/Re-EMF-Projekt/Platine/Bauteile/Mosfet.png

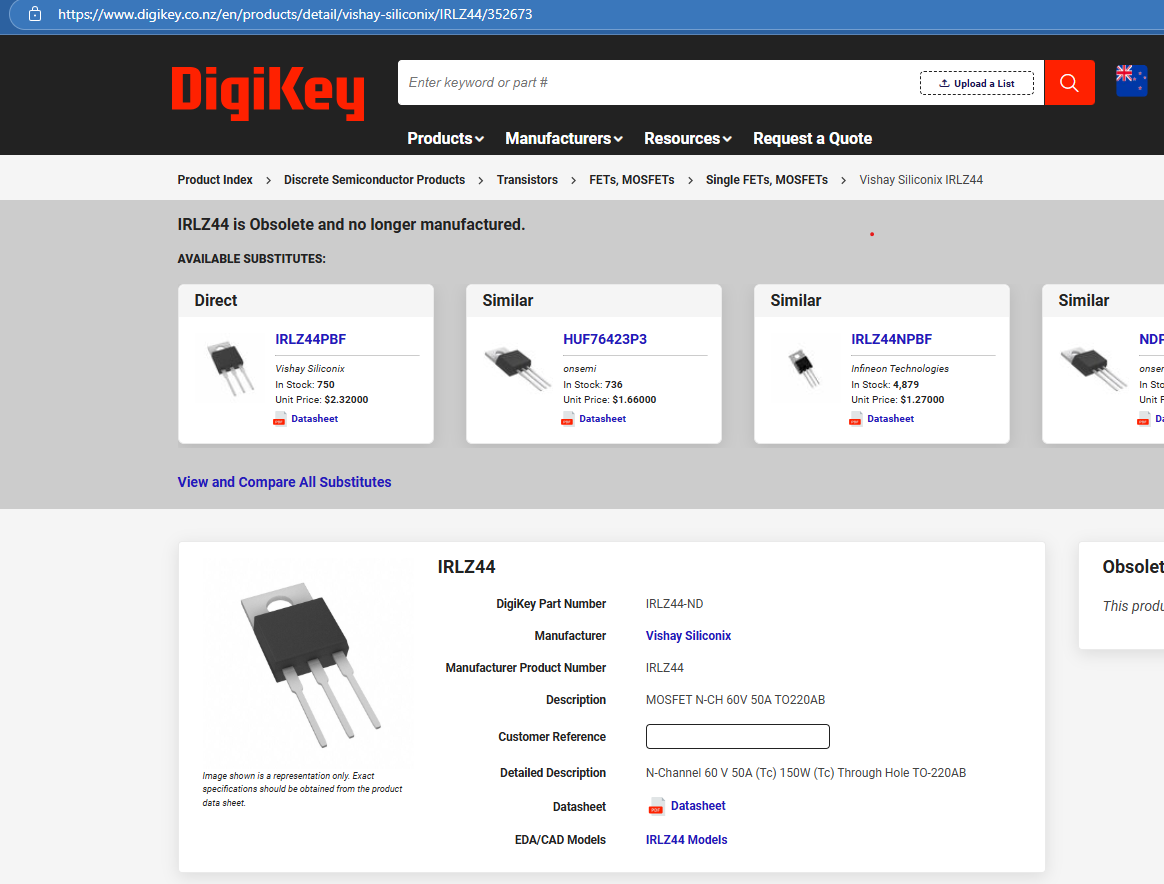
Platine/Bauteile/Mosfet.png
