Johannes-Trummer/Re-EMF-Projekt/Platine/Bauteile/Relais.png

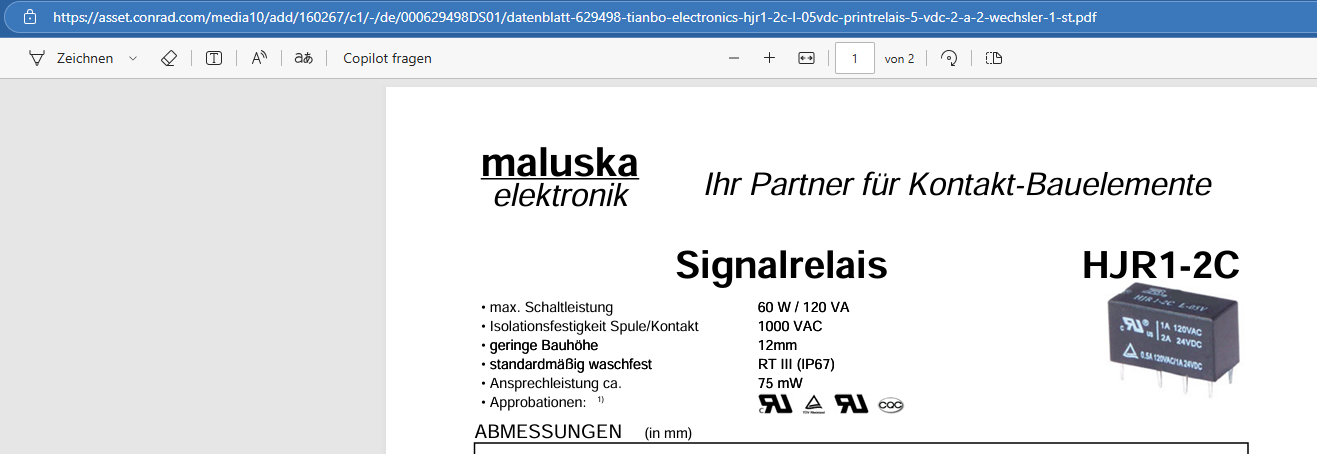
Platine/Bauteile/Relais.png
