Johannes-Trummer/Re-EMF-Projekt/(list of files, cad)

Other CAD files:
Platine/Elektronikentwurf v3.f3z
Platine/Elektronikentwurf v6.f3z
Platine/Elektronikentwurf v8.f3z
