Johannes-Trummer/Re-EMF-Projekt/Platine/Schaltplan_REEMF.pdf

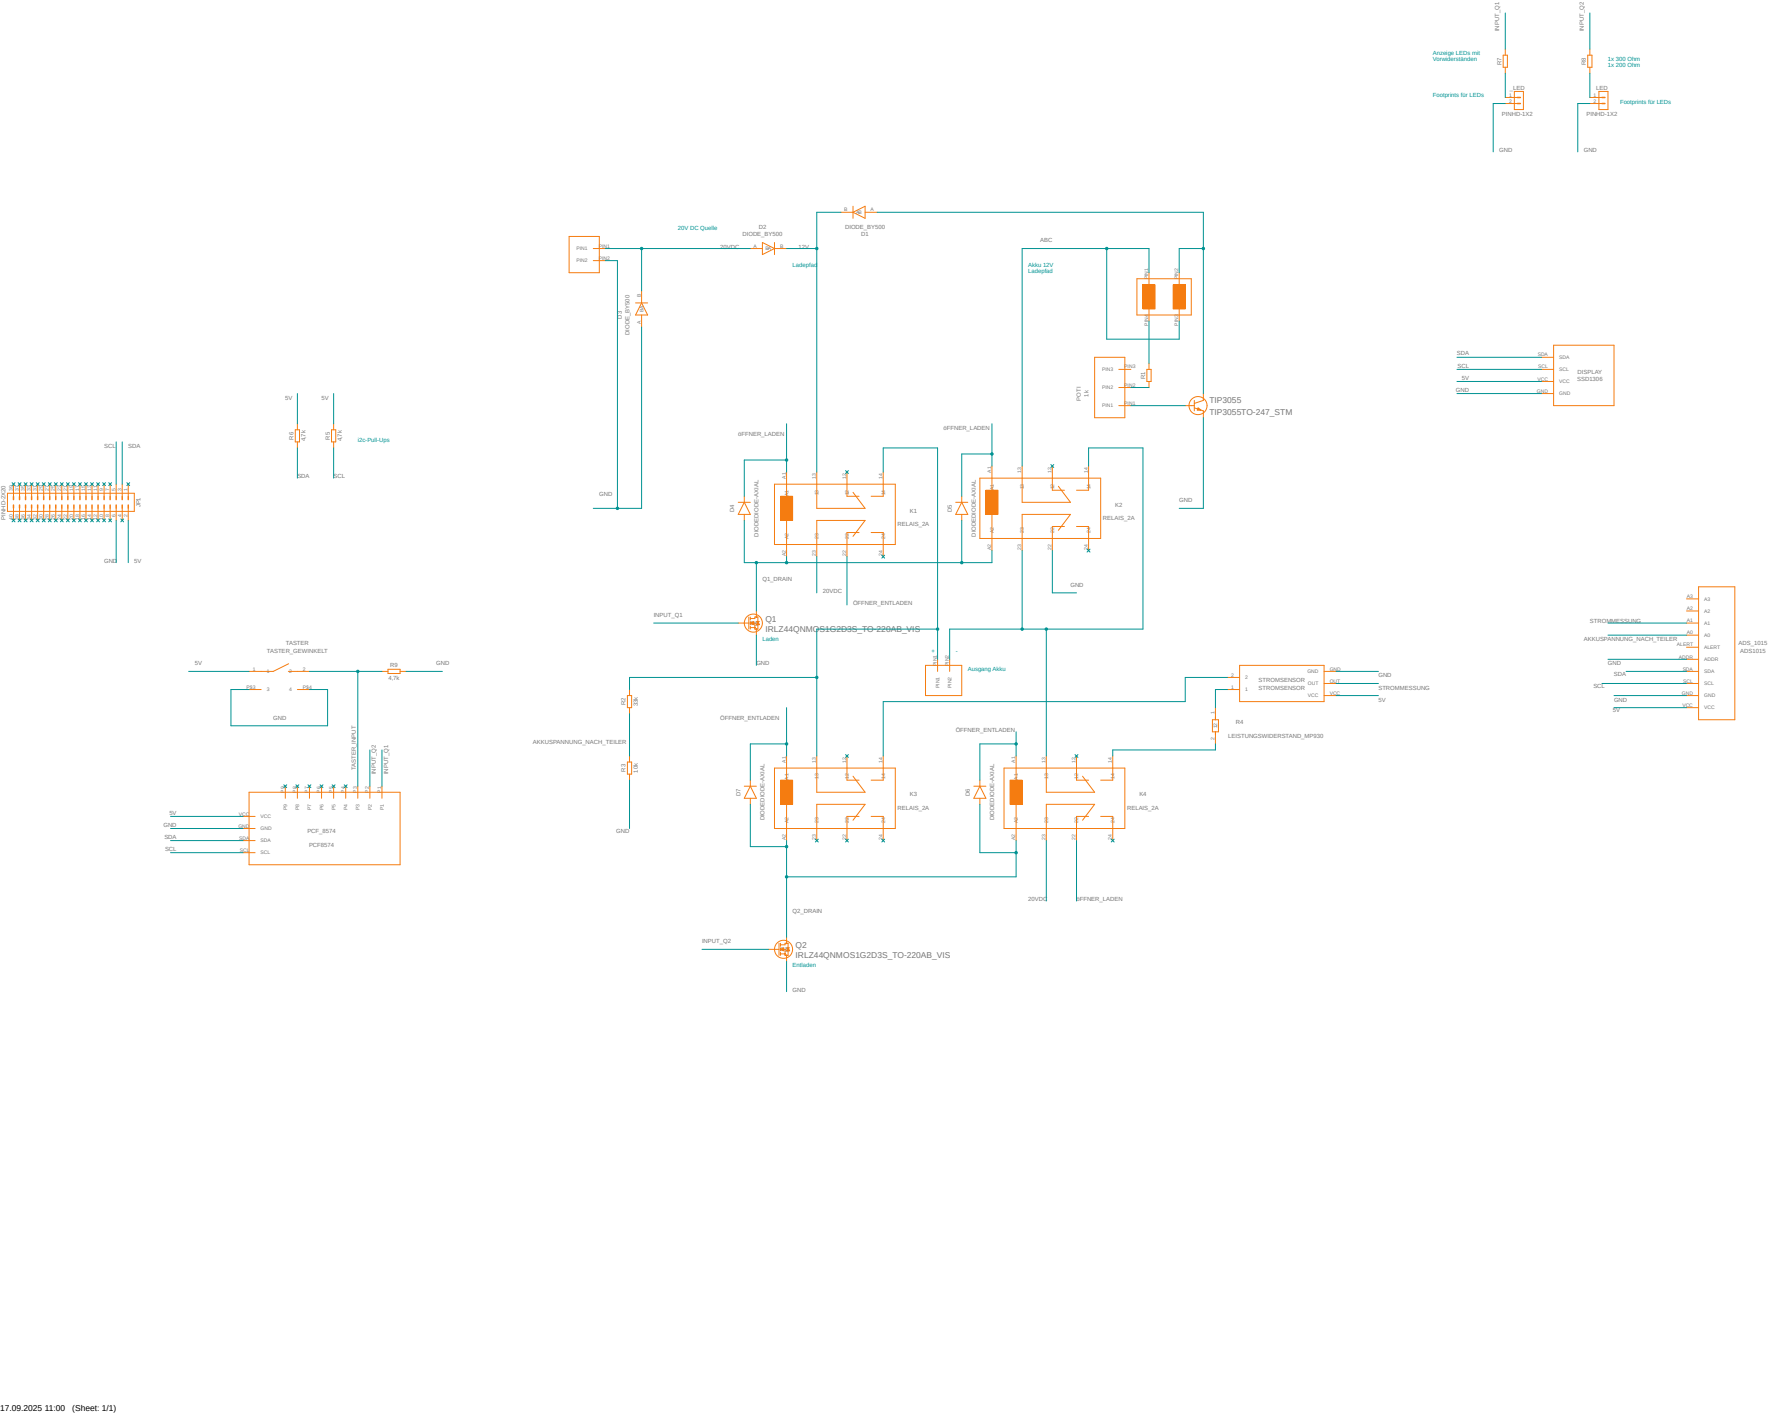
[picture p18: page 1]
