Johannes-Trummer/Re-EMF-Projekt/Platine/Simulation.asc

C1: cap; 470mF
D1: diode
D2: diode
D3: diode
L1: ind2; 0.4mH
L2: ind2; 0.4mH
Q1: npn; 2N3055
R1: res; 1k
R2: res; 10
R3: res; 120
V1: voltage; 20
Named nets: 0
K L1 L2 0.99
.tran 1
.meas TRAN t1  TRIG V(n001) VAL=40 RISE=1
.meas TRAN t2  TRIG V(n001) VAL=40 RISE=2
.meas TRAN period PARAM t2 - t1
.meas TRAN freq PARAM 1 / period
