Johannes-Trummer/Re-EMF-Projekt/(commit log)

2025-05-13 Create Elektronikentwurf v3.f3z
    [Elektronikentwurf v3.f3z]
2025-05-19 Create Elektronikentwurf v6.f3z
    [Elektronikentwurf v6.f3z]
2025-05-19 Create Elektronikentwurf v8.f3z
    [Elektronikentwurf v8.f3z]
2025-06-02 Technische und Physikalische Widersprüche als Dateien vorhanden
